thermseekr/eumesmo-rl-4ch12a-c/README.md

# eumesmo-rl-4ch12a-c

Relay board with 4x 24 VDC Form C (NO + NC) relays. This board is designed to be used togheter with [eumesmo-io-24v16ch](https://github.com/thermseekr/eumesmo-io-24v16ch), but can be driven by any 24V control circuit compatible with NPN inputs. It uses 16A relays and is limited to 12A/channel per copper trace capacity.

The board is compatible with the SP7 DIN rail system from Metaltex.

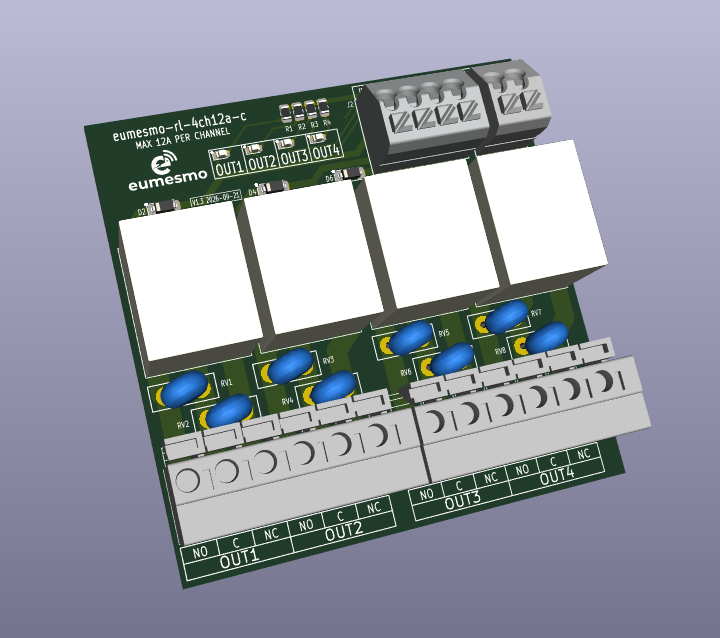
[picture p1: V1/eumesmo-rl-4ch12a-c-v1.3.png]
eumesmo-rl-4ch12a-c


## VERSION HISTORY

V1.3 - 2026/09/21 - Repository renamed from eumesmo-rl-4ch12A-nc to eumesmo-rl-4ch12A-c to reflect the change on the relay contact form.

V1.2 - 2026/06/13 - Repository renamed from RELAY-24V-4CH-12A-NC to eumesmo-rl-4ch12A-nc to align the design with the eumesmo line of building automation products.

V1.1 - 2026/06/13 - Input terminal blocks replaced from 2.54mm to 3.5mm pitch for easier installation in the field.

V1.0 - Initial release.

## LICENSE

This project is licensed under the [Creative Commons BY-NC 4.0 License](https://creativecommons.org/licenses/by-nc/4.0/).
Commercial use is not permitted without prior written consent. See the [LICENSE.txt](LICENSE.txt) file for details.
