thermseekr/eumesmo-rl-4ch12a-c/V1/production/bom.csv

Designator | Footprint | Quantity | Value | LCSC Part #
D1, D3, D5, D7 | 0603 | 4 | ORANGE/0603 | C2987557
D2, D4, D6, D8 | D_SOD-123 | 4 | 1N4148 | C81598
J1 | TerminalBlock_Wago_250-202_1x02_P3.5mm_45Degree | 1 | 250-202 | C475154
J2 | TerminalBlock_Wago_250-204_1x04_P3.5mm_45Degree | 1 | 250-204 | C475156
J3, J4 | TerminalBlock_Dibo_DB142V-5.08-6P_1x06_P5.08mm_Vertical | 2 | DB142V-5.08-6P | C2898703
K1, K2, K3, K4 | Relay_SPDT_Songle_SRD_FormC | 4 | Songle_SRD_1C | C15840
R1, R2, R3, R4 | 0805 | 4 | 10k/125mW | C17414
RV1, RV2, RV3, RV4, RV5, RV6, RV7, RV8 | RV_Disc_D9.50mm_W3.6mm_P5.08mm | 8 | 275VAC | C2761646
