thermseekr/eumesmo-rl-4ch12a-c/V1/eumesmo-rl-4ch12a-c-v1.kicad_pcb

## KiCad design V1/eumesmo-rl-4ch12a-c-v1.kicad_pcb (2026-10-19)

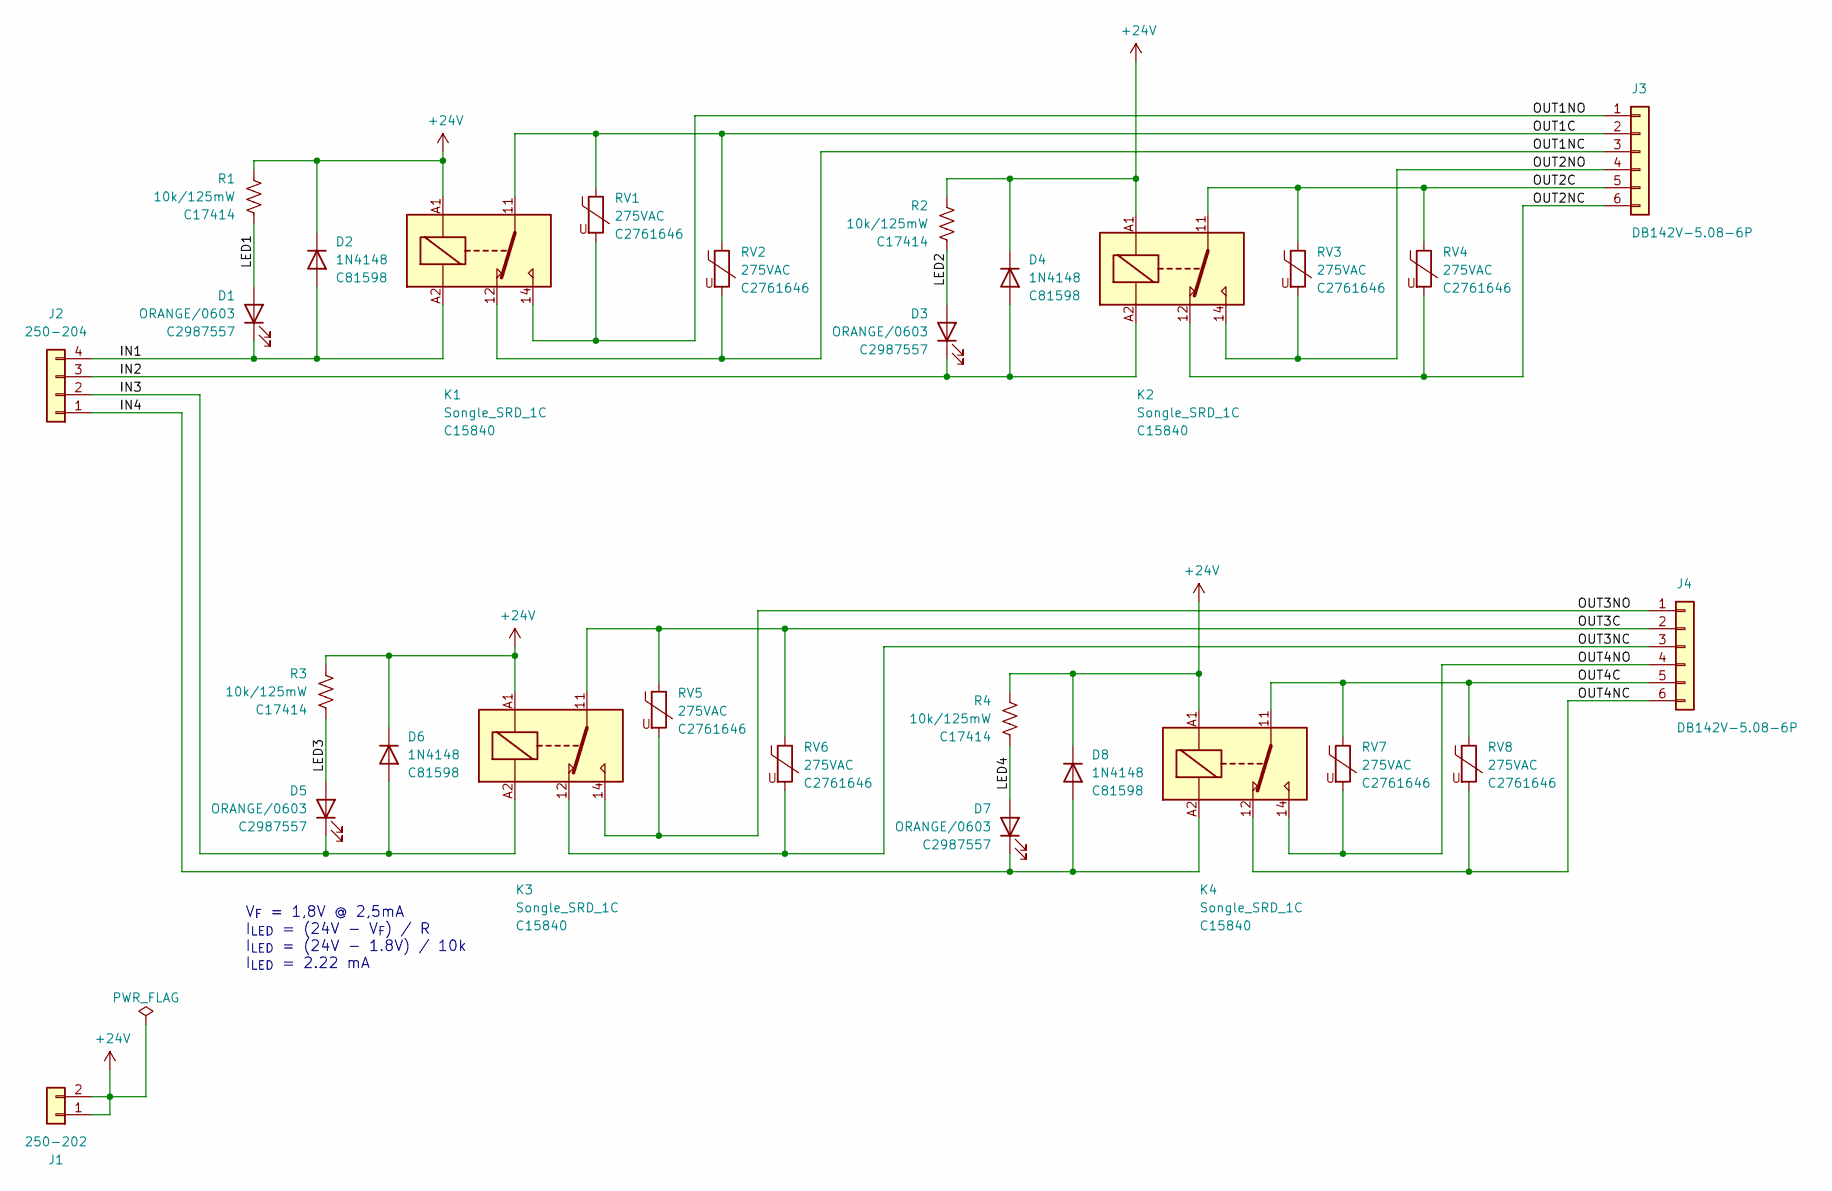
[picture p2: schematic eumesmo-rl-4ch12a-c-v1.kicad_sch, eumesmo 4x 24V form C relay Module]

Parts:
D1, D3, D5, D7: ORANGE/0603; LED_0603_1608Metric; Mfr PN 19-217/S2C-AL1M2VY/6T; LCSC Part # C2987557
D2, D4, D6, D8: 1N4148; D_SOD-123; Mfr PN 1N4148W; LCSC Part # C81598
J1: 250-202; TerminalBlock_Wago_250-202_1x02_P3.5mm_45Degree; Mfr PN KF250-3.5-2P-1; LCSC Part # C475154
J2: 250-204; TerminalBlock_Wago_250-204_1x04_P3.5mm_45Degree; Mfr PN KF250-3.5-4P-1; LCSC Part # C475156
J3, J4: DB142V-5.08-6P; TerminalBlock_Dibo_DB142V-5.08-6P_1x06_P5.08mm_Vertical; Mfr PN DB142V-5.08-6P-GN; LCSC Part # C2898703
K1, K2, K3, K4: Songle_SRD_1C; Relay_SPDT_Songle_SRD_FormC; Mfr PN SRD-24VDC-SL-C; LCSC Part # C15840
R1, R2, R3, R4: 10k/125mW; R_0805_2012Metric; Mfr PN 0805W8F1002T5E; LCSC Part # C17414
RV1, RV2, RV3, RV4, RV5, RV6, RV7, RV8: 275VAC; RV_Disc_D9.50mm_W3.6mm_P5.08mm; Mfr PN RM07D431KC1IE100; LCSC Part # C2761646

Connections:
+24V: D2.1 (K), D4.1 (K), D6.1 (K), D8.1 (K), J1.1, J1.2, K1.A1, K2.A1, K3.A1, K4.A1, R1.1, R2.1, R3.1, R4.1
/IN1: D1.1 (K), D2.2 (A), J2.4, K1.A2
/IN2: D3.1 (K), D4.2 (A), J2.3, K2.A2
/IN3: D5.1 (K), D6.2 (A), J2.2, K3.A2
/IN4: D7.1 (K), D8.2 (A), J2.1, K4.A2
/LED1: D1.2 (A), R1.2
/LED2: D3.2 (A), R2.2
/LED3: D5.2 (A), R3.2
/LED4: D7.2 (A), R4.2
/OUT1C: J3.2, K1.11, RV1.1, RV2.1
/OUT1NC: J3.3, K1.12, RV2.2
/OUT1NO: J3.1, K1.14, RV1.2
/OUT2C: J3.5, K2.11, RV3.1, RV4.1
/OUT2NC: J3.6, K2.12, RV4.2
/OUT2NO: J3.4, K2.14, RV3.2
/OUT3C: J4.2, K3.11, RV5.1, RV6.1
/OUT3NC: J4.3, K3.12, RV6.2
/OUT3NO: J4.1, K3.14, RV5.2
/OUT4C: J4.5, K4.11, RV7.1, RV8.1
/OUT4NC: J4.6, K4.12, RV8.2
/OUT4NO: J4.4, K4.14, RV7.2

Notes on the sheet:
V_{F} = 1,8V @ 2,5mA I_{LED} = (24V - V_{F}) / R I_{LED} = (24V - 1.8V) / 10k I_{LED} = 2.22 mA

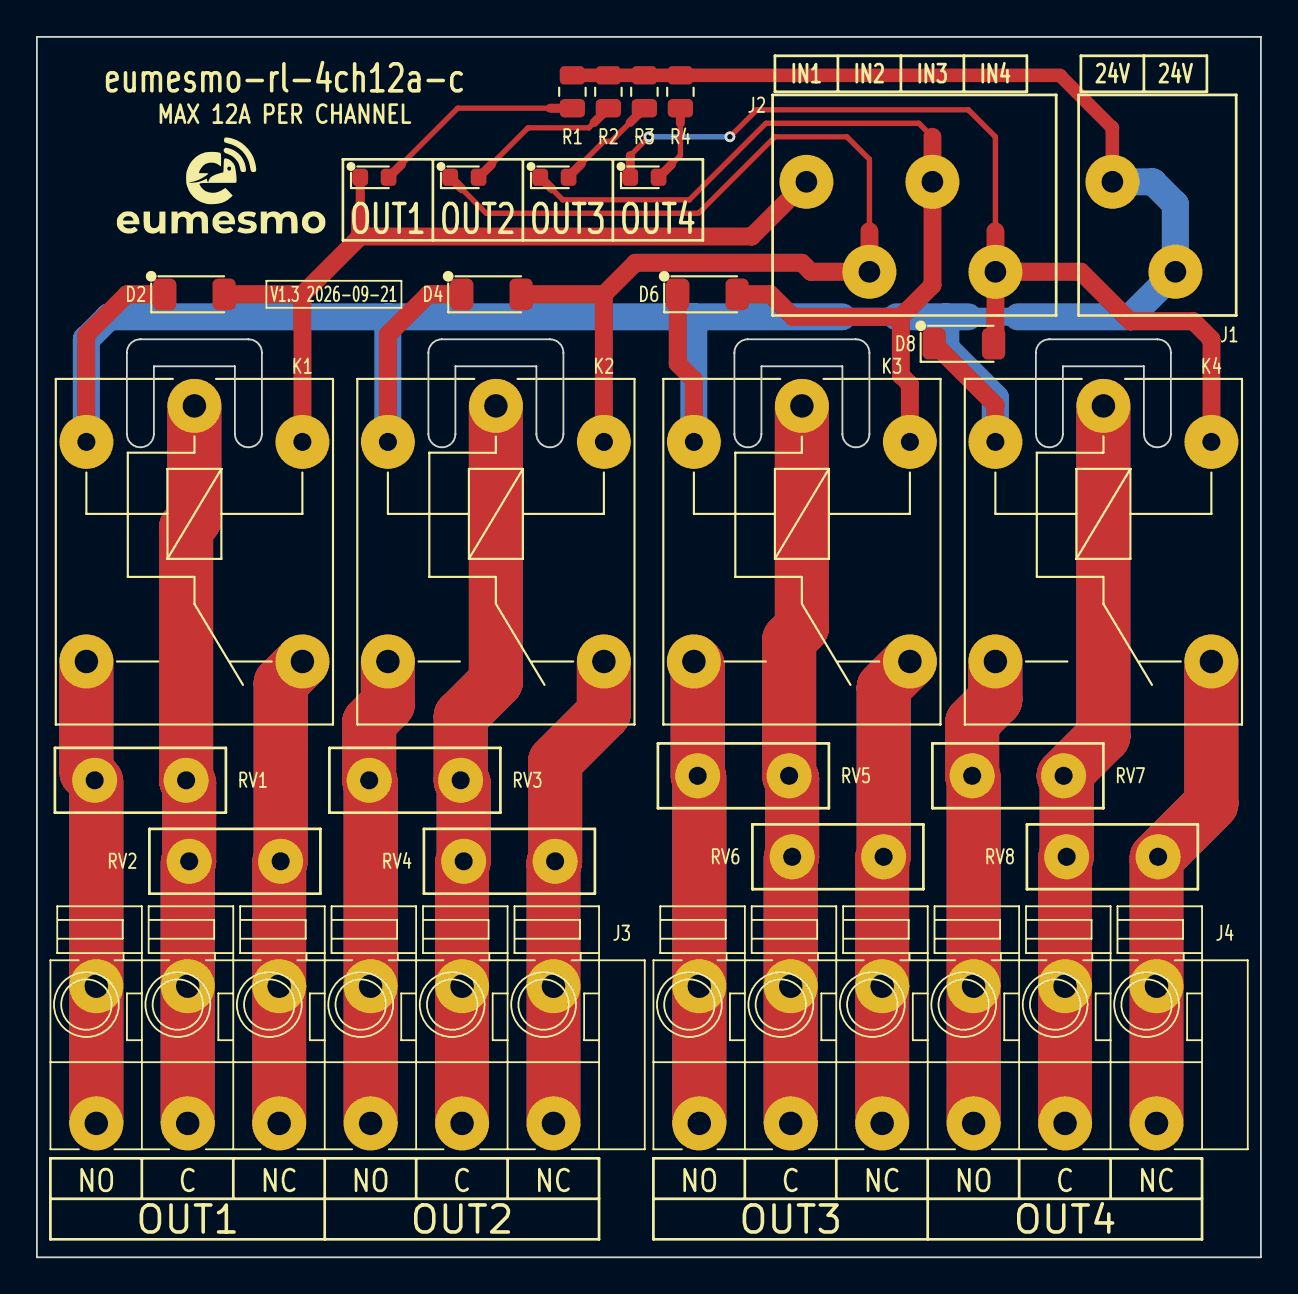
[picture p3: board eumesmo-rl-4ch12a-c-v1.kicad_pcb from above]

Board: 2 copper layers, 68.0 x 67.8 mm, 28 parts (0 on the bottom side), 21 nets.
