thermseekr/eumesmo-rl-4ch12a-c/(commit log)

2026-08-05 Generated DXF for EPLAN
    [eumesmo-rl-4ch12a-nc-v1-Edge_Cuts.dxf, eumesmo-rl-4ch12a-nc-v1.kicad_pcb]
2026-09-11 LEDs changed to orange
    [bom.csv, eumesmo-rl-4ch12a-nc-v1.kicad_pcb, eumesmo-rl-4ch12a-nc-v1.kicad_sch]
2026-09-11 LEDs replaced for orange
    [bom.csv, eumesmo-rl-4ch12a-nc-v1.kicad_pcb, eumesmo-rl-4ch12a-nc-v1.kicad_sch]
2026-09-21 Adjusted component rotation and offset information for JLCPCB.
    [eumesmo-rl-4ch12a-nc-v1.kicad_pcb, eumesmo-rl-4ch12a-nc-v1.kicad_sch, positions.csv]
2026-09-21 Rename repository and update README details
    Updated relay description and image to reflect the change from NC to Form C relays. Added version history for the repository name change.
2026-09-21 Replaced NC with form C (NO + NC) relays.
    [eumesmo-rl-4ch12a-nc-v1.kicad_pcb, eumesmo-rl-4ch12a-nc-v1.kicad_sch]
2026-09-21 Repo renamed.
    [bom.csv, designators.csv, eumesmo-rl-4ch12a-c-v1.kicad_pcb, eumesmo-rl-4ch12a-c-v1.kicad_sch, eumesmo-rl-4ch12a-nc-v1-Edge_Cuts.dxf, positions.csv]
2026-09-21 Updated component visible fields.
    [eumesmo-rl-4ch12a-c-v1.kicad_pcb, eumesmo-rl-4ch12a-c-v1.kicad_sch]
2026-09-24 Repositined terminal blocks
    [eumesmo-rl-4ch12a-c-v1.kicad_pcb, positions.csv]
2026-10-19 Replaced Wago connectors for other brand, no stock.
    [bom.csv, eumesmo-rl-4ch12a-c-v1.kicad_pcb, eumesmo-rl-4ch12a-c-v1.kicad_sch]
